corbinstreehouse/ChargerControl/Parts list.rtfd/Pasted Graphic.tiff

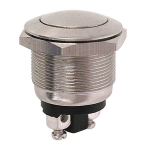
Parts list.rtfd/Pasted Graphic.tiff
