corbinstreehouse/ChargerControl/ChargerControl/README.txt

Charger Control project
by Corbin Dunn
http://www.corbinstreehouse.com
