corbinstreehouse/ChargerControl/Notes.rtf

Arduino Manzanita Micro PFC Charger Control

NOTE: should I get a 12v-> 5v step down for the vin of the thing?

Need:
* connection to LCD display so I can put it further away (possibly)
* connection mechanism for the external wires

External connects:

?? AC input and
12v (car battery)
12v gnd
12v from AC-DC converter
pilot signal
proximity signal
inlet ground
BMS vsource out
BMS HLIM input

separate block:
manzanita + 5v (pin 1)
manzanita off (pin 2)
Total: 8 inputs/outputs

I want:
1. Easy plugin from manzanita micro charger (using a telephone jack thing) (these are 2 inputs)
2. Wire in and screw down for the rest
3. Wire out for the LCD display (unless I have it put in there permanently, which is my current plan)

PIN_BMS_POWER (currently 4) will turn on the BMS via relay. The BMS is powered by the AC-DC converter.
PIN_EVSE_PILOT (currently 5) will be used to turn the pilot signal on and off (to open/close the EVSE contractor)
PIN_CHARGER_OFF (currently 6) will be used by Arduino to send 5V to turn off the charger when doing timed charging, or when unplugged (hopefully the current amount doesn't matter)
PIN_ARDUINO_OFF (currently 7) will turn off the Arduino via the Pololu Push Button power
PIN_EVSE_PROXIMITY A0 (input). will be used to read if the proximity signal is open/closed when the latch on the plug is pressed so we can stop charging

When initially turned on, the boot process:
1. Initialize everything: BMS off, charger off (via 5v signal), pilot off, proximity check
2. If the charging mode is "normal":
a. Turn on BMS (always before generating the pilot signal)
b. Turn on pilot signal
c. Only turn on the charger when the proximity is "latched"
3. When charging
a. Watch for the proximity signal to change (unlatched or unplugged)

A. If timed charging..

B. If regular charging..
1. Turn on the BMS by applying power to PIN_BMS_POWER
2. Turn on the EVSE by ???

When unplugged occurs we want to do a soft shutdown of the charger.
1. Turn off the charger by powering PIN_CHARGER_OFF
2. Turn off BMS power (which also turns off the charger by opening HLIM)

When the timer occurs we want to:
1. Turn off the charger by applying 5v to PIN_CHARGER_OFF
2. Turn off the EVSE's power, which cuts the AC-DC converter power (so don't do too many things for much longer to avoid draining the car's 12v battery)
3. A short time later (second?) Turn off the BMS by cutting the relay (turning off PIN_BMS_POWER)
4. A short time later, turn off the Arduino via applying > X? volts to PIN_ARDUINO_OFF

For relays, information:
http://www.instructables.com/id/Connecting-a-12V-Relay-to-Arduino/ (use a 10k resistor)
http://www.arduino.cc/playground/uploads/Main/relays.pdf // says a 1k or 2.2k…why so low?

Proximity Detection:
1. Analog read from PIN_EVSE_PROXIMITY
When using 2.7k resistor:
if : ~4.3v (value=906), not connected (stop charging)
if: ~2.7v (value=568), connected but not latched (stop charging, if charging)
if: ~1.55v (value=327), connected and latched (okay to charge)
When using a 10k resistor:
if : ~4.7v (value=991), not connected (stop charging)
if: ~2.85v (value=601), connected but not latched (stop charging, if charging)
if: ~1.60v (value=337), connected and latched (okay to charge)

HLIM (High Limit for when charging) in Elithion is set to "normally open", and closes when it *can* charge. This is for failsafe, so if the BMS dies the charger will just get a feed of 5v from itself and not charge.

Charger pin reference via Elithion
http://lithiumate.elithion.com/pdf/iface_Manzanita%20Micro.pdf
http://lithiumate.elithion.com/php/manzanita_micro.php

J1772 reference:
http://en.wikipedia.org/wiki/File:J1772_signaling_circuit.gif
http://4.bp.blogspot.com/_i_c2BM_uBw4/TR9mOulEE5I/AAAAAAAACDs/8dVMihzK9JA/s1600/J1772-1.jpg
http://code.google.com/p/open-evse/wiki/J1772Basics
