corbinstreehouse/ChargerControl/Fry's Shopping list.rtf

Fry's shopping list
metal push button
metal switch (12v dc for now)

2x: KSP2222A Transistor (NPN)
2x: TIP102 transistor (not going to use but want to have)
2x: 1N4004 diode (maybe buy 2 extra) // 5v (and 12v?)
2x: 1N4003 diode // 12 v diode, low amps
diodes are for low amps, low current (i.e.: 5v and 12v)

pilot relay: switching 12v low current
BMS relay: switching 12v, low current (say 5 amps)
charger relay: switching 5v, *very* low current

Buy 5'ish of each:

150 ohm resistor ?
1k resistor
2.2k resistor
2.74k resistor
1.3k resistor
