corbinstreehouse/ChargerControl/Parts list.rtfd/TXT.rtf

Parts list for Charger Control

Spark Fun:
Arduino Nano for the mount
or Leonardo: http://www.adafruit.com/products/849

Pololu power switch
http://www.sparkfun.com/products/8904
http://www.instructables.com/id/Using-the-Pololu-Pushbutton-Power-Switch/

Push button switch:
http://www.amazon.com/Momentary-N-O-Metal-Button-Switch/dp/B001TLBBES
http://www.amazon.com/Momentary-Metal-Flush-Button-Switch/dp/B001TL979E/ref=pd_sim_e_4

¬

Relay (any appropriately rated relay)
5v relay for switching the 12v pilot signal with the arduino
http://www.sparkfun.com/products/100

stackers:
http://www.adafruit.com/products/85

Shields:
2x:
Adafruit Proto Shield for Arduino Kit - v.5
http://www.adafruit.com/products/51
or: http://www.sparkfun.com/products/7914

Wire bolt down things

Optional:
TouchShield Slide OLED -- this might be cool

Button extenders? How to extend the buttons on the LCD shield display

Buttons:
X? buttons to use for the LCD TFT display

DC-DC converter
12v to 7v for the arduino (see: Leonardo page; it wants 7v input to provide 5v output)
http://www.sparkfun.com/products/9370 // $30
http://www.thebox.myzen.co.uk/Tutorial/Protection.html
http://www.sparkfun.com/products/9370 // $30
http://www.thebox.myzen.co.uk/Tutorial/Protection.html

http://www.sparkfun.com/products/9370 // $30
http://www.digikey.com/product-detail/en/OKI-78SR-5%2F1.5-W36-C/811-2196-5-ND/2259781?cur=USD // cheap - $4.30, but not efficient.
http://www.digikey.com/product-detail/en/V7805-1500/102-2171-ND/2352130 // $10.86
OR: use a PMIC - Voltage Regulators - DC DC Switching Regulators (http://www.digikey.com/product-search/en/integrated-circuits-ics/pmic-voltage-regulators-dc-dc-switching-regulators/2556570)
IE: http://www.digikey.com/product-detail/en/LM2576-5.0WT/576-1518-5-ND/1027686

OR: http://www.arduino.cc/cgi-bin/yabb2/YaBB.pl?num=1236735887/15
http://code.google.com/p/multidisplay/wiki/Powersupply
from: http://www.arduino.cc/cgi-bin/yabb2/YaBB.pl?num=1239996764/13#13
+ parts list:
http://code.google.com/p/multidisplay/wiki/PartList1
+ heatsink…

NOTE: better voltage regulator:

http://www.digikey.com/product-highlights/us/en/cui-v78-regulators/1177

voltage regulator:
http://www.digikey.com/product-detail/en/V7805-2000/102-2175-ND/2352134

for the power supply (converts 12v to 7v and stabilizes it)

1 - 40uH 2amp power inductor
http://www.mouser.com/Search/ProductDetail.aspx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

NOTE: LM7805 from 12v to 5v seems too low; the LCD is really dim when I run it this way because the 5v out from the arduino is more like 4.02 v. Instead, it says 7v input is better, so instead:
http://www.digikey.com/product-detail/en/BA70BC0T/BA70BC0T-ND/722285
+ heat sink...
