corbinstreehouse/ChargerControl/ChargerControl - Eagle/ChargerControlSchematicV1.brd

## EAGLE design ChargerControl - Eagle/ChargerControlSchematicV1.brd (2012-11-09)

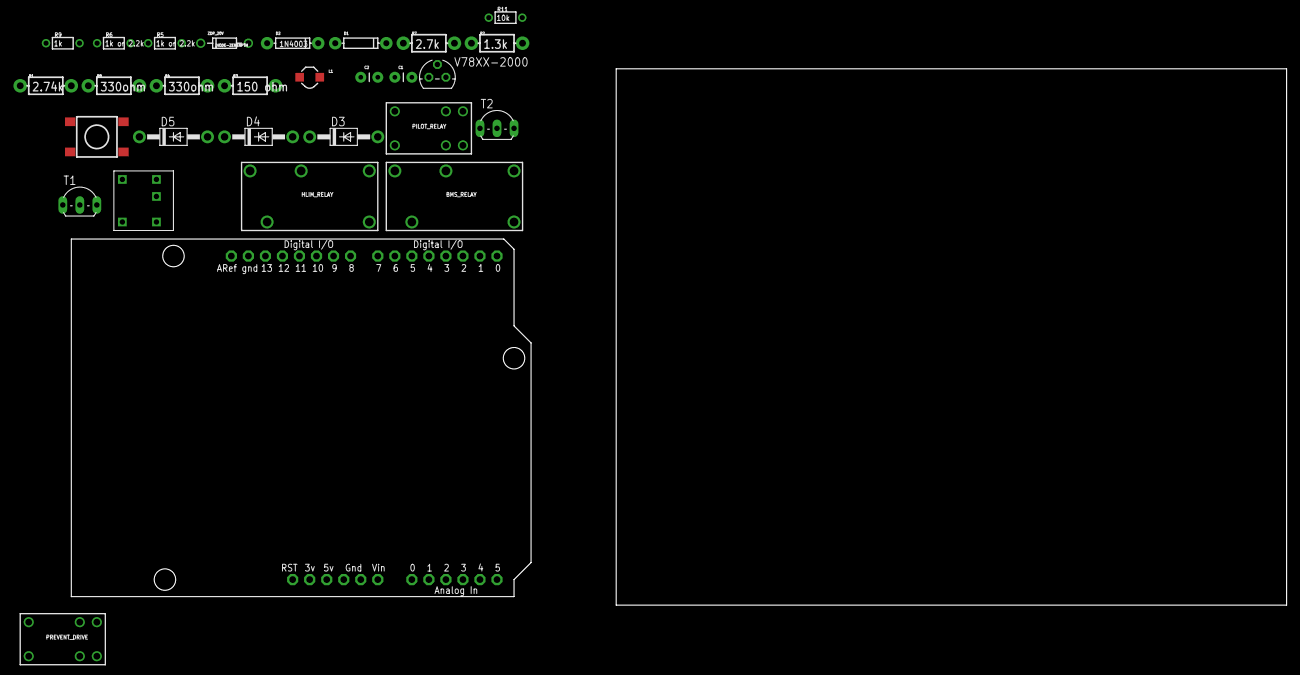
[picture p2: board ChargerControlSchematicV1.brd from above]

Board: 2 copper layers, 181.3 x 80.0 mm, 29 parts (0 on the bottom side), 21 nets, no tracks yet.

Parts:
BMS_RELAY: RELAYPTH; RELAY-G5Q
C1, C2: 10uF; CAP-PTH-SMALL
D1: DIODE-1N4148
D2: 1N4003; DIODE-1N4148
D3, D4, D5: 1N4004; DO41-10
HLIM_RELAY: RELAYPTH; RELAY-G5Q
L1: 40uH 2amp; CDRH2D09
LATCH_SWITCH: SWITCH-MOMENTARY-2; TACTILE_SWITCH_TALL
PILOT_RELAY: RELAY-2G5Q; RELAY-G5V
PREVENT_DRIVE: RELAY-2G5Q; RELAY-G5V
R1: 2.74k; AXIAL-0.3-KIT
R2: 1.3k; AXIAL-0.3-KIT
R3: 150 ohm; AXIAL-0.3-KIT
R4, R8: 330ohm; AXIAL-0.3-KIT
R5, R6: 1k or 2.2k; 1/6W-RES
R7: 2.7k; AXIAL-0.3-KIT
R9: 1k; 1/6W-RES
R11: 10k; 1/6W-RES
T1, T2: 2N2222; TO92-EBC-OVAL
U$1: POLOLU_PSHBTN_PWR; POLO_PSHBTN_PWR
U$2: ARDUINOUNO; ARDUINO
V78XX-2000: 78L05Z; TO92
ZDP_20V: DIODE-ZENERPTH; DIODE-ZENER

Connections:
240_AC_GND: LATCH_SWITCH.A2, R8.P$1
AC-DC-12V-OUT: U$2.VIN, V78XX-2000.1
CAR_12V+: BMS_RELAY.5, D3.C, D4.C, L1.P$1, PREVENT_DRIVE.2, U$1.P$4, U$1.P$5, ZDP_20V.P$1
GND: C2.2, PREVENT_DRIVE.9, R1.P$2, R7.P$2, T1.E, T2.E, U$1.P$1, V78XX-2000.2, ZDP_20V.P$2
HLIM: D5.A, D5.C, HLIM_RELAY.5, R11.2, U$2.D2
unnamed: U$1.P$2, U$2.GND1
unnamed: R9.1, U$2.D6
unnamed: R6.1, U$2.D4
unnamed: D2.C, R1.P$1, R2.P$1
unnamed: R5.2, T1.B
unnamed: R5.1, U$2.D5
unnamed: R4.P$2, R11.1, U$2.5V
unnamed: D3.A, PILOT_RELAY.9, T1.C
unnamed: BMS_RELAY.1, D4.A, T2.C
unnamed: R6.2, T2.B
unnamed: D1.A, R9.2
unnamed: LATCH_SWITCH.B2, R3.P$2, R8.P$2
unnamed: C2.1, L1.P$2, V78XX-2000.3
PILOT_RELAY: U$1.P$3, U$2.D7
PIN2: D1.C, HLIM_RELAY.2
PROXIMITY: R3.P$1, R4.P$1, R7.P$1, U$2.A0
