corbinstreehouse/ChargerControl/(commit log)

2012-06-02 added more charging options
2012-06-07 After a lot of project cleanup to not copy files from Arduino
2012-06-09 Implemented the timer. Added the ability to set the current time for the RTC.
2012-06-10 ordered parts; implemented scrolling and charging status.
2012-06-10 Allow editing the duration (buggy)
    [ChargerControl.cpp, CrbMenu.cpp, CrbMenu.h]
2012-06-20 Add more code to optionally not use a relay for the pilot signal. but it isn't safe to do so w/the manzanita charger.
2012-11-03 new bms waiting state
2012-11-04 New code to turn the charger relay on and off explicitly and not use the BMLS High limit pull down.
2012-11-09 Add eagle schematic
    [ChargerControlSchematicV1.brd, ChargerControlSchematicV1.sch]
2012-11-13 Unfortunately, my EVSE at home goes into “error mode” if it detects the plug is plugged in and the car isn’t charging for X amount of time (not sure what X is). So, to work around that, if we are doi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
    [ChargerControl.cpp]
2012-11-17 Revert "Unfortunately, my EVSE at home goes into “error mode” if it detects the plug is plugged in and the car isn’t charging for X amount of time (not sure what X is). So, to work around that, if we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
    This reverts commit 6580267e00a060ff7d8a626078f34422cd39f4f3.
    [ChargerControl.cpp]
2012-11-17 Show time option added. Fixed the prix test to be "smarter". Use a 5v out signal for the prox test so it isn't always "hot" which was messing up my home EVSE
    [ChargerControlSchematicV1.sch]
2012-11-17 Updated board layout.
